Keksejs/SpindzeLED/BatteryBox_Body.stl

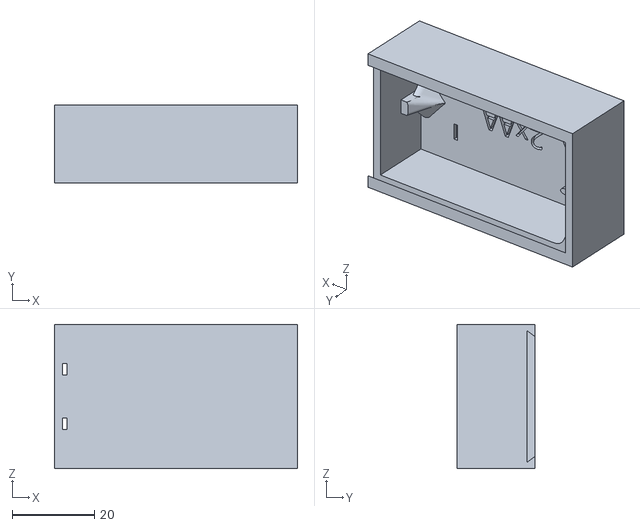
[picture p5: CAD file, 2021-12-09]
BatteryBox_Body.stl
59.0 x 19.0 x 35.0
