Keksejs/SpindzeLED/BatteryBox_Lid.stl

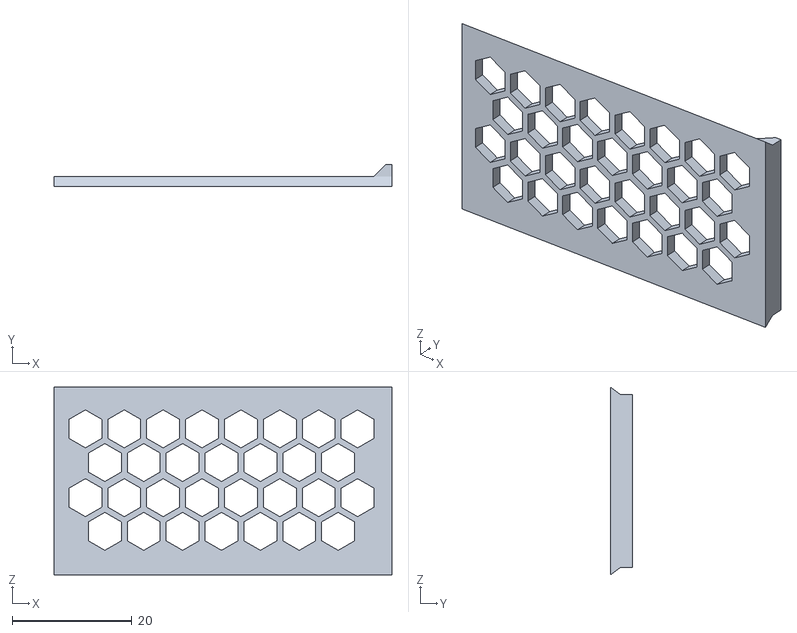
[picture p6: CAD file, 2021-12-09]
BatteryBox_Lid.stl
56.5 x 3.70 x 31.4
