Keksejs/SpindzeLED/(list of files, cad)

Other CAD files:
BatteryHolderBox.f3d
