Keksejs/SpindzeLED/PCB.pdf

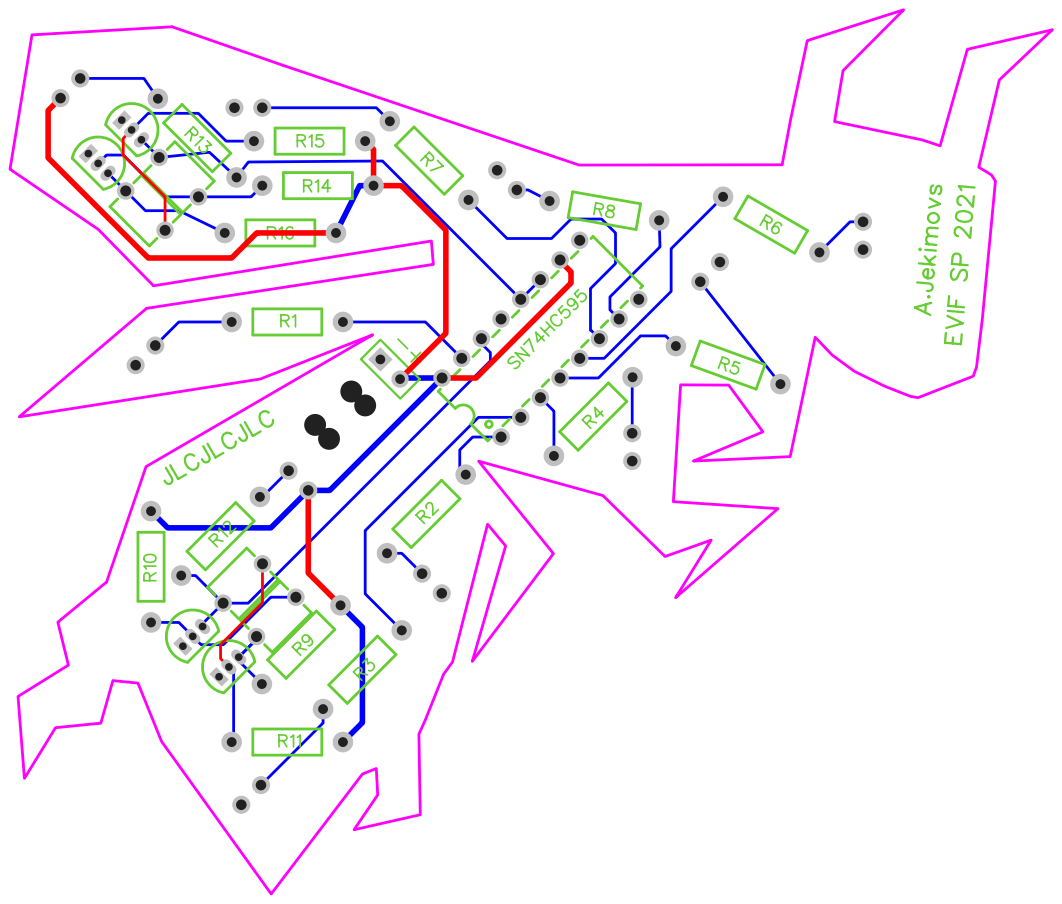
[picture p7: page 1]
