Keksejs/SpindzeLED/Principiālā Shēma.pdf

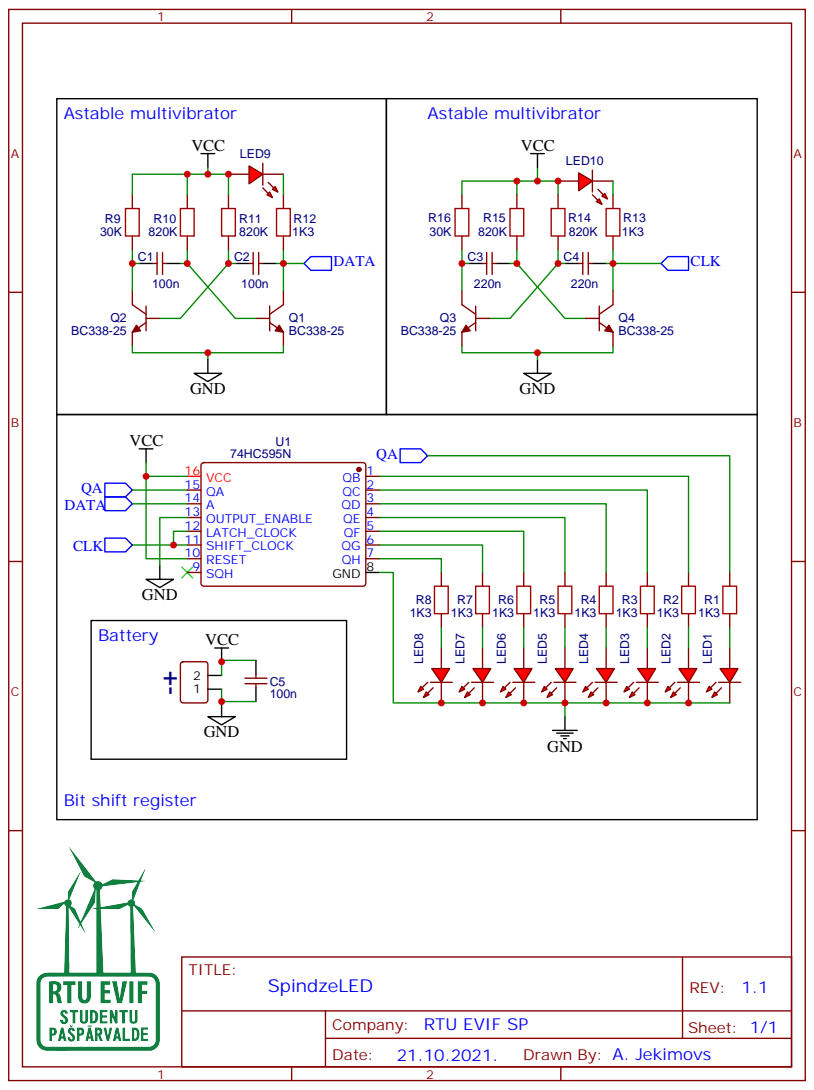
[picture p8: page 1]

Company: RTU EVIF SP
